danieldaquino/RoboPost/Web/README.md

# RoboPost Photon Web Code
## Crafted by Daniel Walnut

## Prerequisites for running

make sure you create a json file called 'keys.json', with your device ID and your key.

here is the content you need to fill in:

{
	"ID": "<yourIDhere>",
	"token": "<yourAccessToken>"
}
