danieldaquino/RoboPost/Hardware/Circuit/LineBot.kicad_pcb

## KiCad design Hardware/Circuit/LineBot.kicad_pcb (2018-04-29)

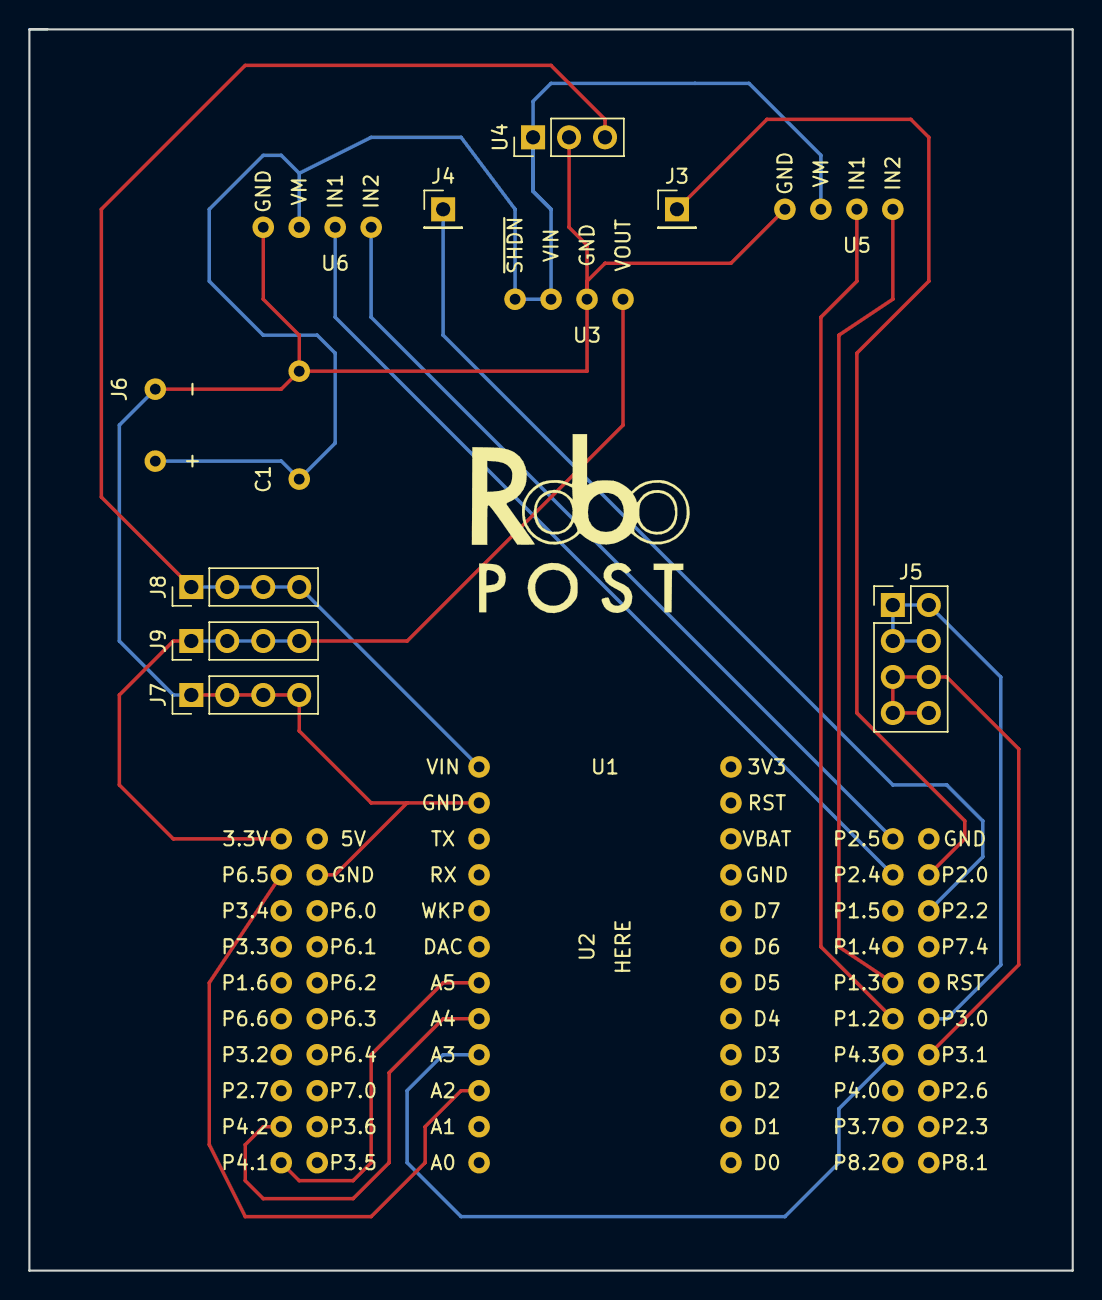
[picture p2: board LineBot.kicad_pcb from above]

Board: 2 copper layers, 73.7 x 87.6 mm, 14 parts (0 on the bottom side), 16 nets.

Parts:
C1: 0.1u; CAP
J3: LEFT ENCODER; Pin_Header_Straight_1x01_Pitch2.54mm
J4: RIGHT ENCODER; Pin_Header_Straight_1x01_Pitch2.54mm
J5: I2C BUS; Pin_Header_Straight_2x04_Pitch2.54mm
J6: BATTERY TERMINAL; BATTERYBLOCK
J7: GND; Pin_Header_Straight_1x04_Pitch2.54mm
J8: 5V POWER; Pin_Header_Straight_1x04_Pitch2.54mm
J9: 3.3V POWER; Pin_Header_Straight_1x04_Pitch2.54mm
U1: MSP430
U2: Photon
U3: D24V6F3
U4: L7805; Pin_Header_Straight_1x03_Pitch2.54mm
U5, U6: DRV8871

Connections:
/LEFT_MOTOR_FORWARD: U1.36, U5.2
/LEFT_MOTOR_REVERSE: U1.35, U5.1
/MISO: U1.9, U2.8
/MOSI: U1.10, U2.7
/RIGHT_MOTOR_FORWARD: U1.32, U6.2
/RIGHT_MOTOR_REVERSE: U1.31, U6.1
/SCL: J5.5, J5.6, J5.7, J5.8, U1.27
/SCLK: U1.37, U2.9
/SDA: J5.1, J5.2, J5.3, J5.4, U1.26
/~SS: U1.2, U2.10
GND: C1.2, J6.2, J7.1, J7.2, J7.3, J7.4, U1.12, U2.2, U3.2, U4.2, U5.4, U6.4
unnamed: C1.1, J6.1, U3.3, U3.4, U4.1, U5.3, U6.3
unnamed: J3.1, U1.22
unnamed: J4.1, U1.23
unnamed: J8.1, J8.2, J8.3, J8.4, U2.1, U4.3
unnamed: J9.1, J9.2, J9.3, J9.4, U1.1, U3.1
