danieldaquino/RoboPost/(commit log)

2018-03-02 Forked TI pwmled with TIRTOS example as a starting point. Also added the GCC build folder, changed the makefile and kept Windows CCS config files
2018-03-03 Changed maximum pwm duty cycle to 88%, but it goes to 90% (measured)
2018-03-03 Added UART Terminal
2018-03-03 Added automatic building bash script for the gcc toolchain, and coded an interrupt counter with a button
2018-03-09 NO MORE CC3220. Switching to MSP430 + Particle Photon
2018-03-11 Implemented Dual Motor driving, and implemented reverse PWM signal
    [DualMotorDriver.c, DualMotorDriver.h, DualVelocityGauge.c, DualVelocityGauge.h]
2018-03-11 Added small test for 2 motor driving. Motor works. Logging is screwed up.
2018-03-11 Fixed hard coded limit where there was supposed to be a MACRO.
    [UARTIO.c, UARTIO.h]
2018-03-11 Fixed multiple bugs preventing the two Motor control from working
    [DualMotorDriver.c, DualMotorDriver.h]
2018-03-11 Added the dual motor controller as a module. I still need to set automatic Feedback updates
2018-03-13 Added partial schematics
    [LineBot.kicad_pcb, LineBot.sch]
2018-03-13 implemented i2c but still have problem with defines
    [UARTIO.c]
2018-03-13 Added an integrator and a saturator, and eliminated almost completely the steady state error
    [DualMotorController.c]
2018-03-13 Fixed wiring mistake, disabled the negative duty cycle for now
    [DualMotorController.c]
2018-03-14 commented on I2C_modual.h file
2018-03-14 Updated motor driver and all dependencies to allow for independent Frequency Modulation besides PWM. Now this is a FPWM motor driver
2018-03-14 Completed a working 3 gear frequency modulation. I was able to go to 90 RPM with +/- 3RPM offset and motor 2 went to 250RPM with low offset
2018-03-14 seperated one module to two: LineSensorDriver and I2C_modual
2018-03-15 Increased UARTIO buffer size and fixed bug that would cause memory conflicts
    [UARTIO.c, UARTIO.h]
2018-03-15 Changed the UARTIOSend to fix a possible stack corruption
    [UARTIO.c, UARTIO.h]
2018-03-15 Added a PD controller to the motor controller, and reduced Kp to add damping and reduce overshoot.
    [DualMotorController.c, DualMotorController.h]
2018-03-15 Fixed the spec on the line following sensor to float from -1 to 0 to 1
    [LineSensorDriver.c, LineSensorDriver.h]
2018-03-16 Fixed multiple bugs with the line cruiser
    [DualMotorController.c, DualVelocityGauge.c, LineSensorDriver.c, LineSensorDriver.h, UARTIO.c, UARTIO.h]
2018-03-24 Added start stop functionality, disabled UART, and made setpoint slower
2018-03-24 Fixed a deadly min curvature radius bug
    [DiffDriver.c]
2018-03-25 Exposed setpoints in diffdriver to outside module, Improved Start Stop logic, Exposed diffDriver setpoints to UART IO, Made robot normally stopped for safety
2018-03-27 Made the GET request to local server turn on and off photon's D7 LED
2018-03-27 Made web interface that turns on or off an LED
2018-03-27 Perfected the system variables, back to test 9, and made the sensor read faster.
2018-03-28 Made many changes to the block drawing, and added relative positioning, and PWM diagram
2018-03-28 Finished first full version of the motor box
2018-03-29 Created better start stop button
2018-04-02 addition of new module:SPI WITH PHOTON
2018-04-02 Moved ucsiSpi module to its own folder, fixed some indentation issues and created blank header file
    [Photon_SPI_Module.c, ucsiSpi.c, ucsiSpi.h]
2018-04-03 Got one way MSP-SPI-PHOTON-TCP-NODE-WEBSOCKETS-WEB of data stream working
2018-04-13 Now the timestamp will be the uptime in milliseconds
2018-04-13 Changed timestamp format to match millis function, preventing short term overflow issues
    [PhotonTCPServer.h, RobotGlobals.h, SPI-WITH-MSP430.h]
2018-04-13 Can communicate through I2C and recognize blue and red
2018-04-14 connected two color and line sensor on the bus and it worked. then optimized code
2018-04-14 Improved UI, fixed bugs
    [DualVelocityGauge.c]
2018-04-15 Increased PWM resolution
2018-04-16 Added CRC checksum, and fixed glitch
    [DualMotorController.c, DualMotorDriver.c, DualMotorDriver.h, Photon_SPI_Module.c, Photon_SPI_Module.h]
2018-04-27 Implemented fork driving
    [LineBot.kicad_pcb]
2018-04-29 Implemented Dynamic Braking
    [LineBot.kicad_pcb, LineBot.sch]
2018-04-29 Revert "Implemented Dynamic Braking"
    This reverts commit b969c98568609f0ee620f5e846148c1e2f46f854.
    Reverted dynamic braking
    [LineBot.kicad_pcb, LineBot.sch]
2018-04-30 implemented color switching instead of stop for 3 sec
2018-05-03 Added measurements setting to 30Hz
